pms67/Airspeed_SensorBoard/README.md

# Airspeed_SensorBoard
 
Differential pressure sensor breakout board with STM32 (I2C-to-SPI) interface.

Repo contains all necessary files for ordering this board, including assembly, at JLCPCB.com (https://jlcpcb.com/RHS).
