pms67/Airspeed_SensorBoard/Airspeed_SensorBoard.kicad_pcb

## KiCad design Airspeed_SensorBoard.kicad_pcb (2021-10-27)

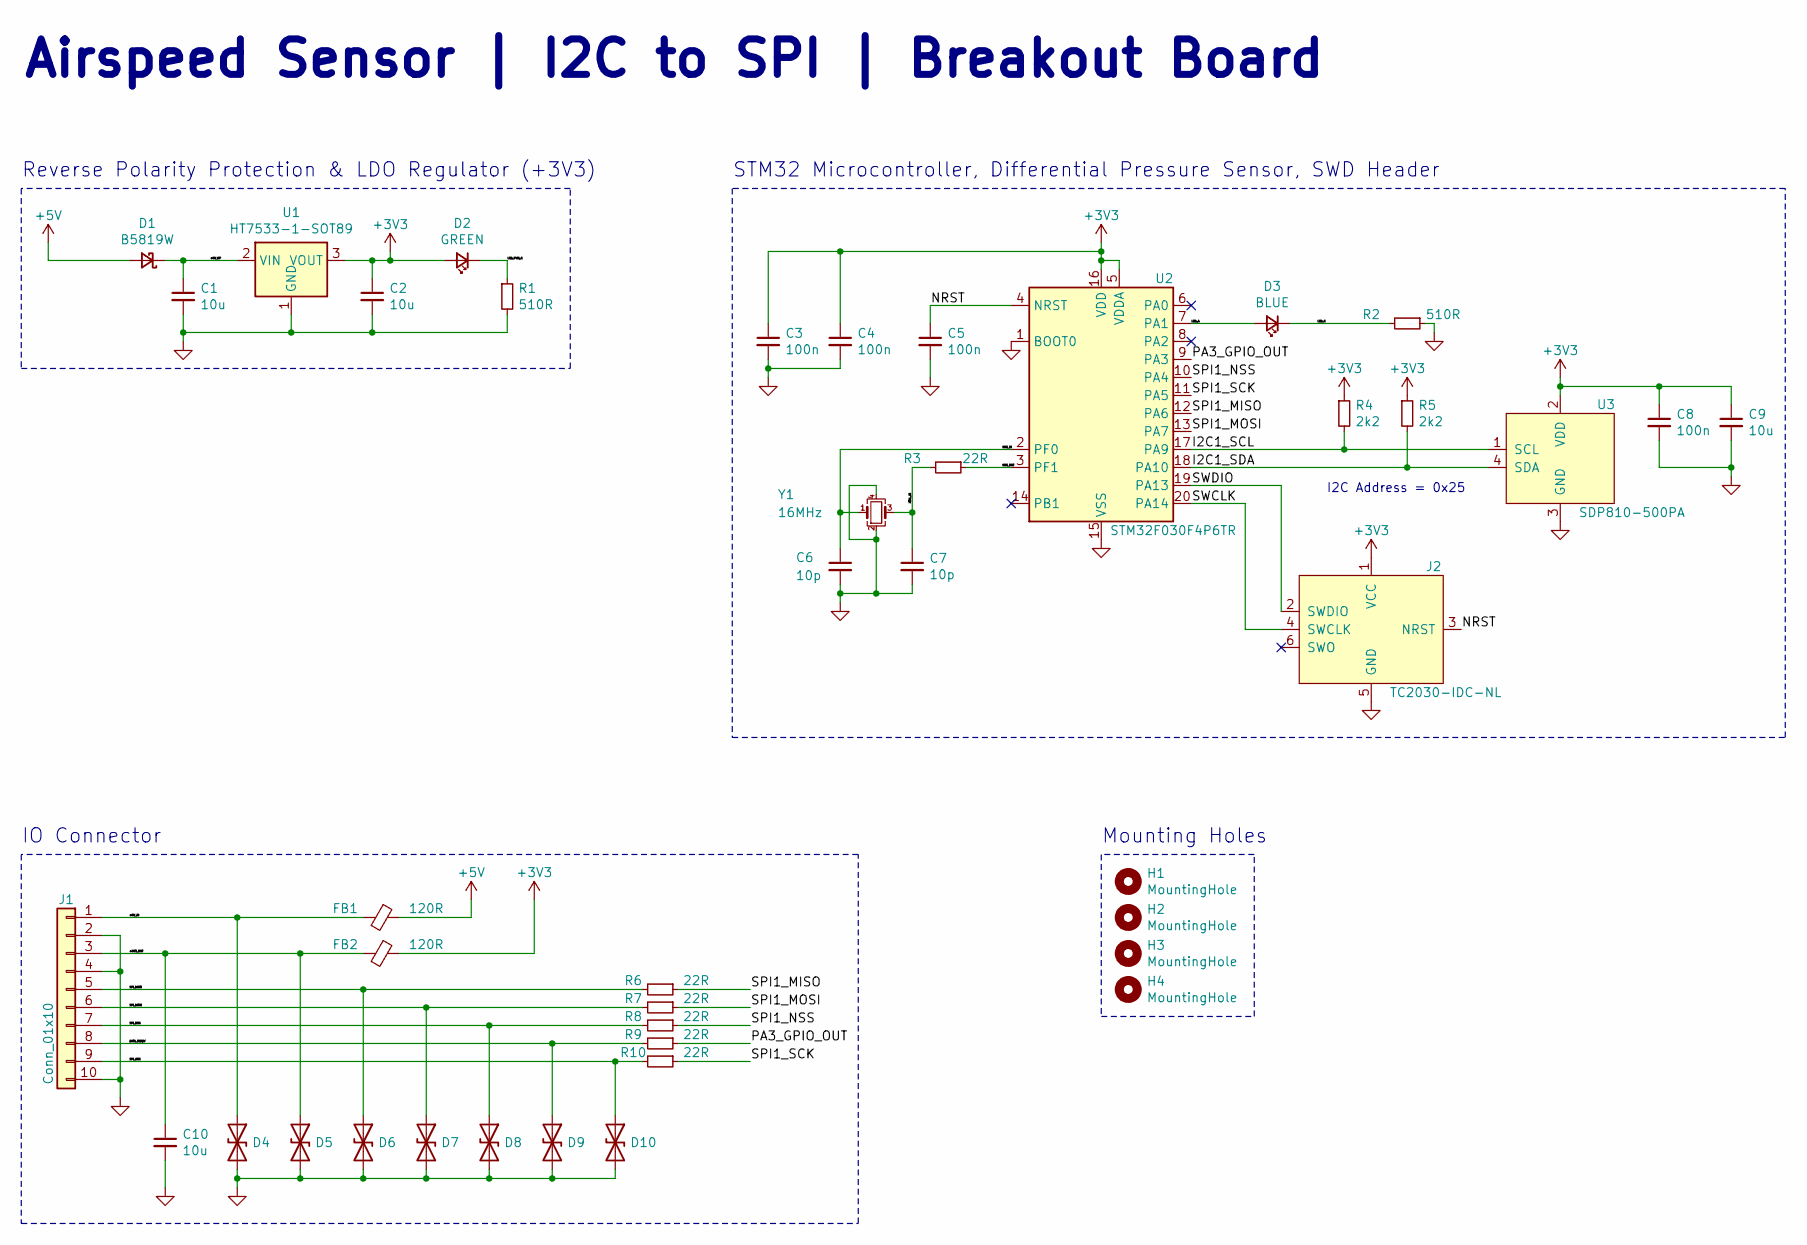
[picture p1: schematic Airspeed_SensorBoard.sch, Speedaliser]

Parts:
C1, C2, C9, C10: 10u; C_0805_2012Metric; LCSC Part # C15850
C3, C4, C5, C8: 100n; C_0402_1005Metric; LCSC Part # C1525
C6, C7: 10p; C_0402_1005Metric; LCSC Part # C32949
D1: B5819W; D_SOD-123; LCSC Part # C8598
D2: GREEN; LED_0603_1608Metric; LCSC Part # C72043
D3: BLUE; LED_0603_1608Metric; LCSC Part # C72041
D4, D5, D6, D7, D8, D9, D10: PESD5V0L1BA,115; D_SOD-323; LCSC Part # C85380
FB1, FB2: 120R; L_0603_1608Metric; LCSC Part # C85831
H1, H2, H3, H4: MountingHole; MountingHole_2.2mm_M2
J1: Conn_01x10; Molex_PicoBlade_53048-1010_1x10_P1.25mm_Horizontal
J2: TC2030-IDC-NL
R1, R2: 510R; R_0402_1005Metric; LCSC Part # C25123
R3, R6, R7, R8, R9, R10: 22R; R_0402_1005Metric; LCSC Part # C25092
R4, R5: 2k2; R_0402_1005Metric; LCSC Part # C25879
U1: HT7533-1-SOT89; SOT-89-3; LCSC Part # C14289
U2: STM32F030F4P6TR; TSSOP-20_4.4x6.5mm_P0.65mm; LCSC Part # C89040
U3: SDP810-500PA; LCSC Part # C153056
Y1: 16MHz; Crystal_SMD_3225-4Pin_3.2x2.5mm; LCSC Part # C13738

Connections:
+3V3: C2.1, C3.1, C4.1, C8.1, C9.1, D2.2 (A), FB2.1, J2.1 (VCC), R4.1, R5.1, U1.3 (VOUT), U2.5 (VDDA), U2.16 (VDD), U3.2 (VDD)
+5V: D1.2 (A), FB1.1
/+3V3_OUT: C10.1, D5.1 (A1), FB2.2, J1.3
/+5V_IN: D4.1 (A1), FB1.2, J1.1
/+5V_RP: C1.1, D1.1 (K), U1.2 (VIN)
/DATA_READY: D9.1 (A1), J1.8, R9.2
/HSE_IN: C6.1, U2.2 (PF0), Y1.1
/HSE_OUT: R3.1, U2.3 (PF1)
/I2C1_SCL: R4.2, U2.17 (PA9), U3.1 (SCL)
/I2C1_SDA: R5.2, U2.18 (PA10), U3.4 (SDA)
/LED_A: D3.2 (A), U2.7 (PA1)
/LED_K: D3.1 (K), R2.2
/LED_PWR_K: D2.1 (K), R1.1
/NRST: C5.1, J2.3 (NRST), U2.4 (NRST)
/PA3_GPIO_OUT: R9.1, U2.9 (PA3)
/SPI1_MISO: R6.1, U2.12 (PA6)
/SPI1_MOSI: R7.1, U2.13 (PA7)
/SPI1_NSS: R8.1, U2.10 (PA4)
/SPI1_SCK: R10.1, U2.11 (PA5)
/SPI_MISO: D6.1 (A1), J1.5, R6.2
/SPI_MOSI: D7.1 (A1), J1.6, R7.2
/SPI_NSS: D8.1 (A1), J1.7, R8.2
/SPI_SCK: D10.1 (A1), J1.9, R10.2
/SWCLK: J2.4 (SWCLK), U2.20 (PA14)
/SWDIO: J2.2 (SWDIO), U2.19 (PA13)
/XTAL_IN: C7.1, R3.2, Y1.3
GND: C1.2, C2.2, C3.2, C4.2, C5.2, C6.2, C7.2, C8.2, C9.2, C10.2, D4.2 (A2), D5.2 (A2), D6.2 (A2), D7.2 (A2), D8.2 (A2), D9.2 (A2), D10.2 (A2), J1.2, J1.4, J1.10, J2.5 (GND), R1.2, R2.1, U1.1 (GND), U2.1 (BOOT0), U2.15 (VSS), U3.3 (GND), Y1.2, Y1.4

Notes on the sheet:
I2C Address = 0x25
Reverse Polarity Protection & LDO Regulator (+3V3)
STM32 Microcontroller, Differential Pressure Sensor, SWD Header
Mounting Holes
IO Connector
Airspeed Sensor | I2C to SPI | Breakout Board

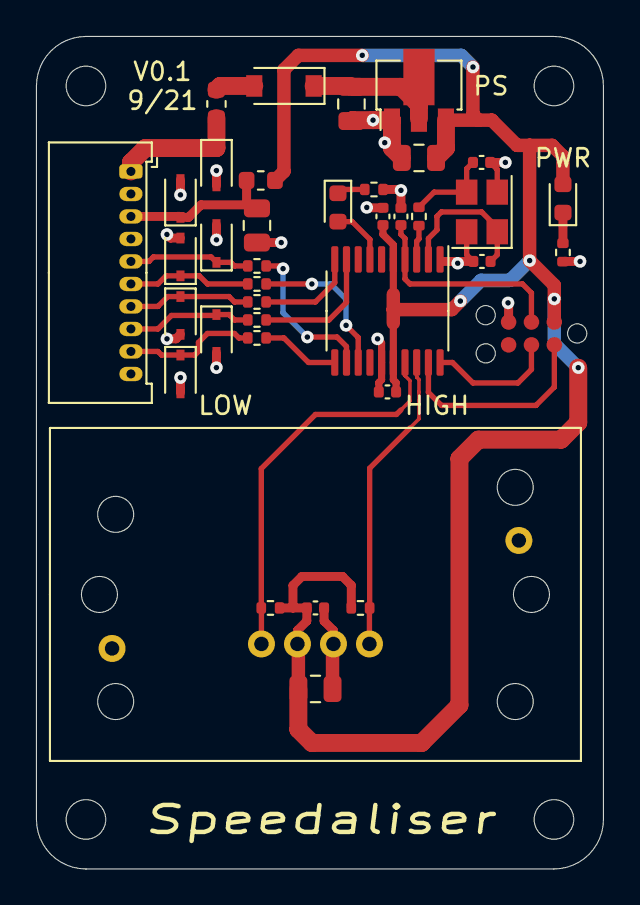
[picture p2: board Airspeed_SensorBoard.kicad_pcb from above]

Board: 2 copper layers, 31.5 x 46.2 mm, 42 parts (0 on the bottom side), 27 nets.
